sscopazzi/Portable_Weather_Station/solidworks_v2/Seperator.SLDPRT

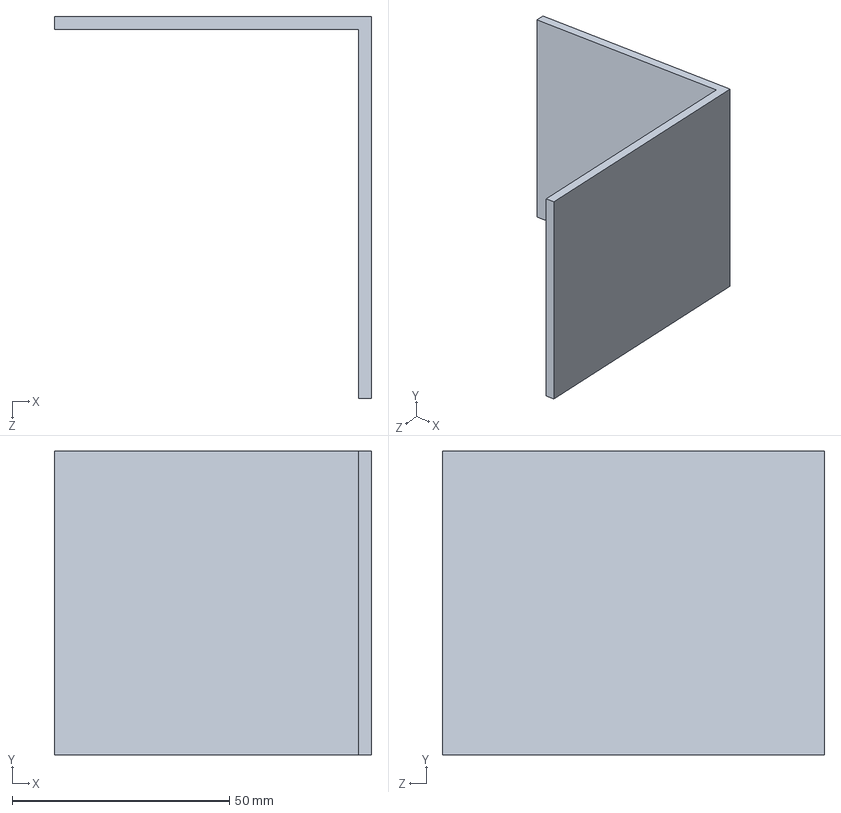
[picture p1: CAD file, 2026-06-11]
solidworks_v2/Seperator.SLDPRT
73.0 x 70.0 x 88.0 mm
