sscopazzi/Portable_Weather_Station/solidworks_v2/Hole_Cover.SLDPRT

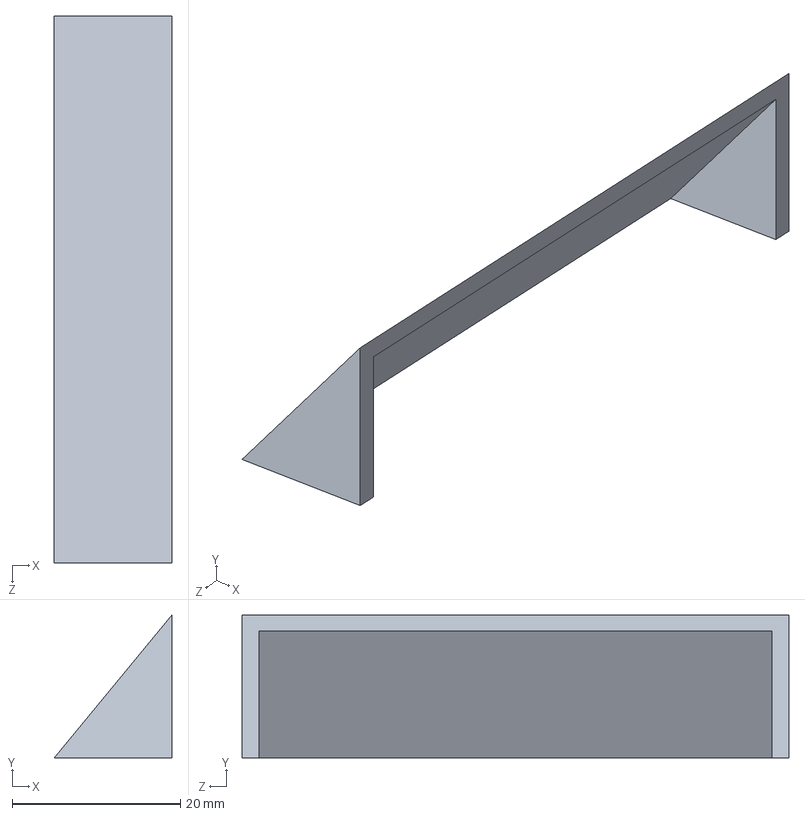
[picture p2: CAD file, 2026-06-11]
solidworks_v2/Hole_Cover.SLDPRT
14.0 x 17.0 x 65.0 mm
