sscopazzi/Portable_Weather_Station/solidworks_v2/Pin.SLDPRT

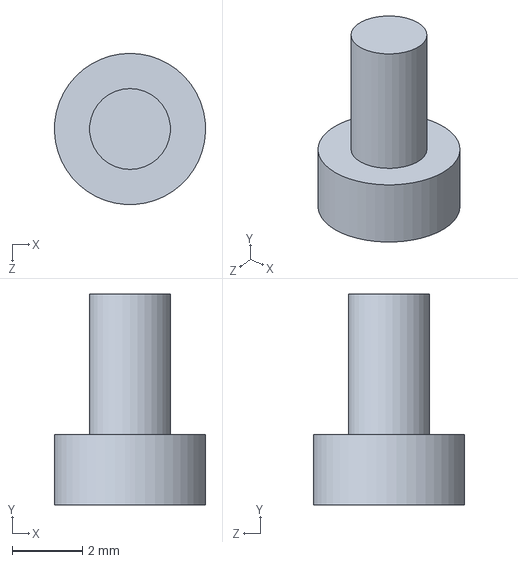
[picture p3: CAD file, 2026-06-11]
solidworks_v2/Pin.SLDPRT
4.30 x 6.00 x 4.30 mm
