sscopazzi/Portable_Weather_Station/solidworks_v2/Sensor_Tray.SLDPRT

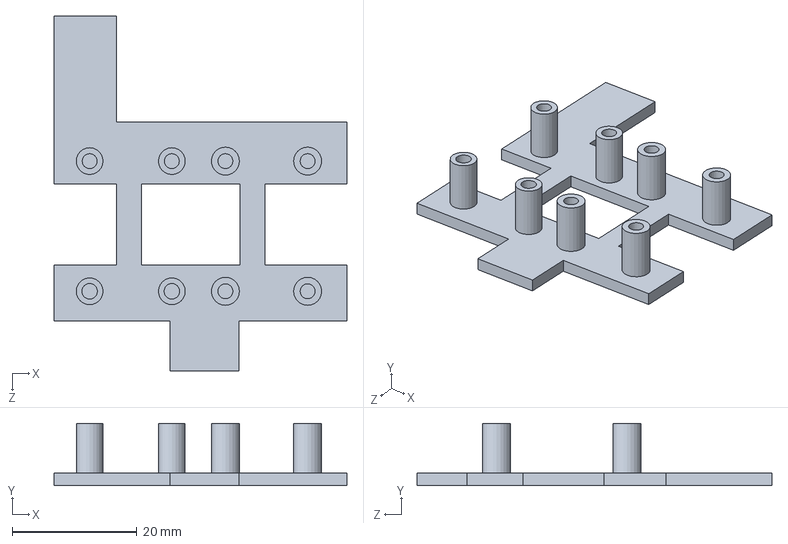
[picture p4: CAD file, 2026-06-11]
solidworks_v2/Sensor_Tray.SLDPRT
47.0 x 10.0 x 57.0 mm
