sscopazzi/Portable_Weather_Station/solidworks_v1/USBC_plug.SLDPRT

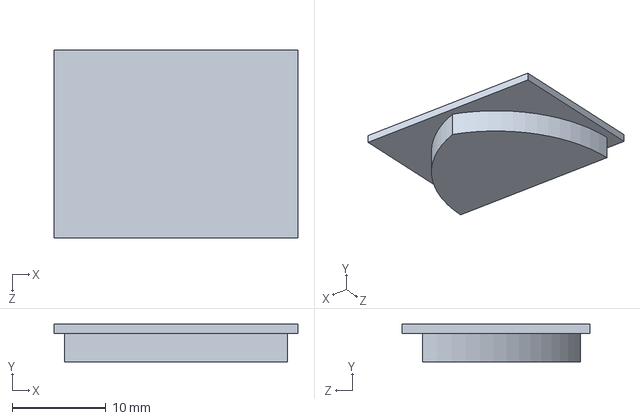
[picture p5: CAD file, 2025-03-13, an earlier design]
solidworks_v1/USBC_plug.SLDPRT
26.0 x 4.00 x 20.0 mm
