sscopazzi/Portable_Weather_Station/solidworks_v1/Box.SLDPRT

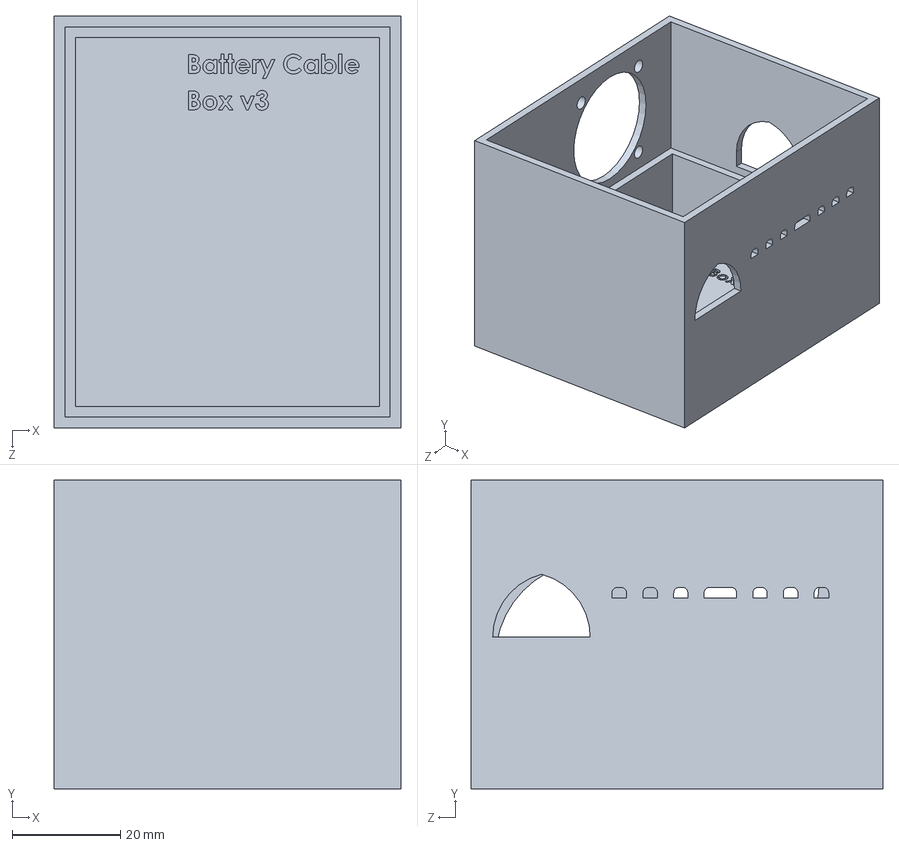
[picture p6: CAD file, 2025-03-13, an earlier design]
solidworks_v1/Box.SLDPRT
64.0 x 57.0 x 76.0 mm
