sscopazzi/Portable_Weather_Station/solidworks_v1/SD_plug.SLDPRT

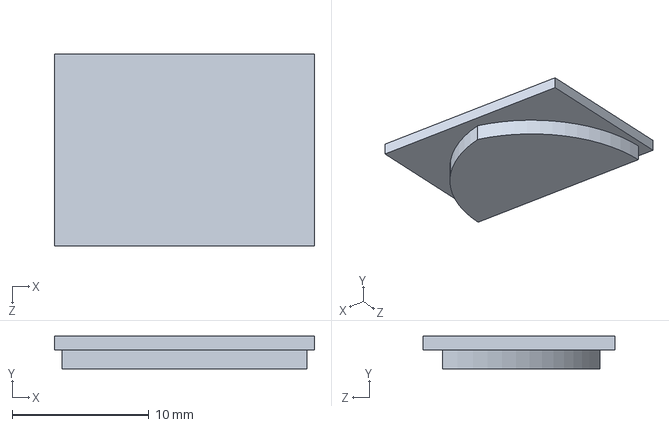
[picture p7: CAD file, 2025-03-13, an earlier design]
solidworks_v1/SD_plug.SLDPRT
19.0 x 2.40 x 14.0 mm
