sscopazzi/Portable_Weather_Station/solidworks_v1/GNSS_holders.SLDPRT

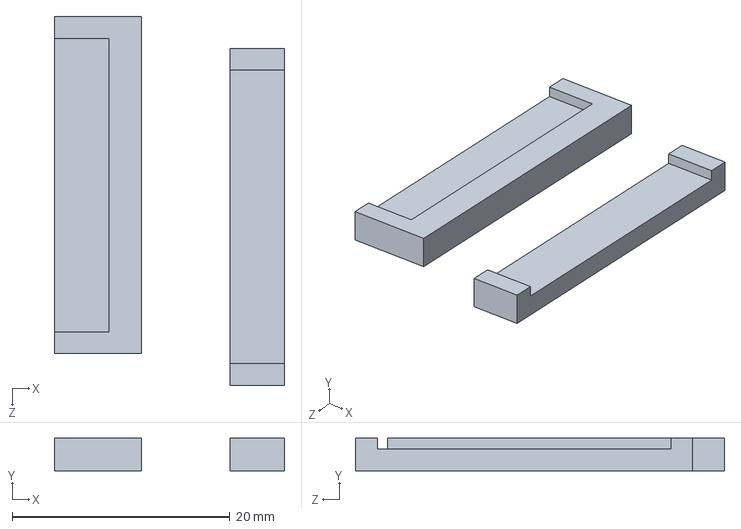
[picture p8: CAD file, 2025-03-12, an earlier design]
solidworks_v1/GNSS_holders.SLDPRT
21.2 x 3.00 x 33.9 mm
