sscopazzi/Portable_Weather_Station/solidworks_v1/Sensor_Tray.SLDPRT

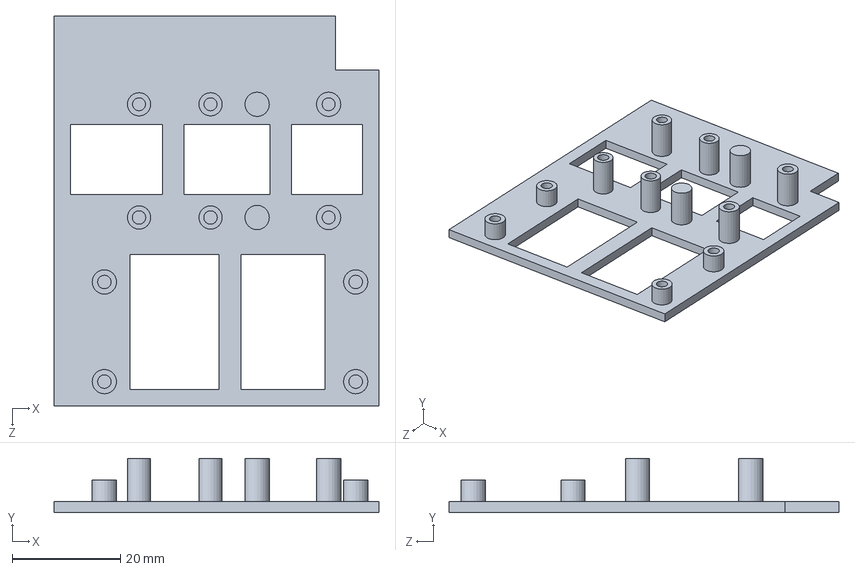
[picture p9: CAD file, 2025-03-12, an earlier design]
solidworks_v1/Sensor_Tray.SLDPRT
60.0 x 10.0 x 72.0 mm
