sscopazzi/Portable_Weather_Station/solidworks_v1/Pin.SLDPRT

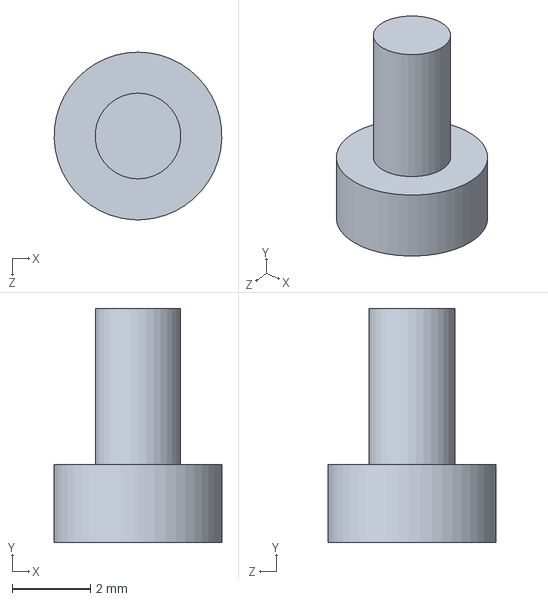
[picture p10: CAD file, 2025-03-12, an earlier design]
solidworks_v1/Pin.SLDPRT
4.30 x 6.00 x 4.30 mm
