sscopazzi/Portable_Weather_Station/solidworks_v1/Top_Cover.SLDPRT

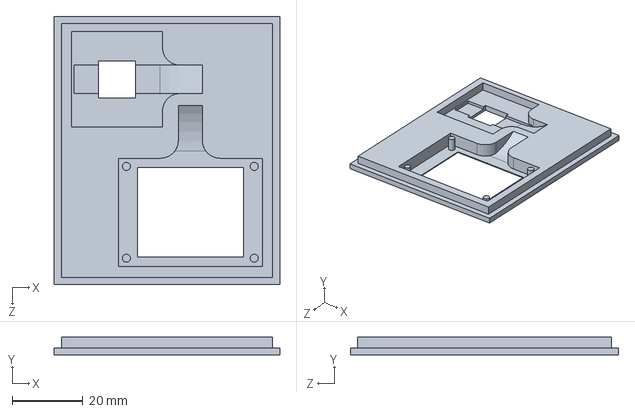
[picture p11: CAD file, 2025-03-12, an earlier design]
solidworks_v1/Top_Cover.SLDPRT
64.0 x 5.00 x 76.0 mm
