sscopazzi/Portable_Weather_Station/(list of files, cad)

Other CAD files:
solidworks_v2/Seperator_no_curve.STL
solidworks_v1/Box.STL
solidworks_v1/GNSS_holders.STL
solidworks_v1/Pin.STL
solidworks_v1/SD_plug.STL
solidworks_v1/Sensor_Tray.STL
solidworks_v1/Top_Cover.STL
solidworks_v1/USBC_plug.STL
solidworks_v2/Hole_Cover.STL
solidworks_v2/Pin.STL
solidworks_v2/Sensor_Tray.STL
solidworks_v2/Seperator.STL
