sscopazzi/Portable_Weather_Station/test_data/20240917_movingTestOne/readme.mkd

### First Walking Test

Starting at northernmost location and walking south. The position was saved every ten seconds. Walking began once a valid position was observed on display.

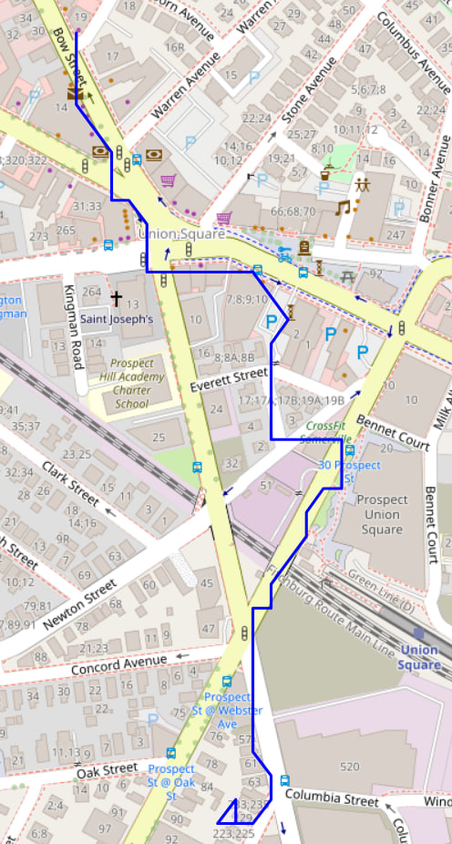
[picture p12: test_data/20240917_movingTestOne/20240917_map.png]
Map
