sscopazzi/Portable_Weather_Station/test_data/20250325_boat_test/20250325_boat_test.txt

time,tempC,tempF,humidity,pressurehPa,fix,fixQual,lat,latDir,lon,lonDir,speed,angle,alt,satNum,vBat
25-3-25 17:56:19,25.34,77.61,5.37,1014.36,1,1,38.1200,N,122.5530,W,2.70,175.87,-0.90,5,3.89
25-3-25 17:56:20,25.33,77.60,5.36,1014.37,1,1,38.1200,N,122.5530,W,2.70,179.19,-1.20,5,3.88
25-3-25 17:56:21,25.32,77.57,5.38,1014.37,1,1,38.1200,N,122.5530,W,2.70,183.11,-1.50,5,3.88
25-3-25 17:56:23,25.30,77.55,5.32,1014.37,1,1,38.1200,N,122.5530,W,2.68,190.78,-2.50,4,3.88
25-3-25 17:56:24,25.29,77.52,5.34,1014.37,1,1,38.1199,N,122.5530,W,2.74,193.00,-2.40,5,3.88
25-3-25 17:56:25,25.27,77.49,5.27,1014.37,1,1,38.1199,N,122.5530,W,2.91,194.67,-0.20,5,3.88
25-3-25 17:56:27,25.26,77.47,5.31,1014.37,1,1,38.1199,N,122.5530,W,3.45,202.16,1.50,5,3.88
25-3-25 17:56:28,25.24,77.44,5.33,1014.38,1,1,38.1199,N,122.5530,W,3.22,197.90,1.90,5,3.89
25-3-25 17:56:30,25.23,77.41,5.31,1014.39,1,1,38.1199,N,122.5530,W,2.97,203.93,2.10,5,3.88
25-3-25 17:56:31,25.21,77.39,5.33,1014.39,1,1,38.1199,N,122.5530,W,2.97,206.87,2.30,5,3.88
25-3-25 17:56:32,25.20,77.36,5.32,1014.40,1,1,38.1199,N,122.5530,W,4.77,205.92,2.30,6,3.88
25-3-25 17:56:34,25.19,77.33,5.46,1014.41,1,1,38.1198,N,122.5530,W,4.75,205.58,2.30,6,3.88
25-3-25 17:56:35,25.17,77.31,5.44,1014.44,1,1,38.1198,N,122.5531,W,2.66,217.43,2.50,6,3.88
25-3-25 17:56:36,25.16,77.30,5.36,1014.46,1,1,38.1198,N,122.5531,W,1.22,245.47,2.90,6,3.87
25-3-25 17:56:38,25.15,77.28,5.34,1014.48,1,1,38.1198,N,122.5531,W,0.45,245.47,3.00,6,3.88
25-3-25 17:56:39,25.14,77.25,5.33,1014.51,1,1,38.1198,N,122.5531,W,1.02,243.39,3.00,6,3.88
25-3-25 17:56:40,25.13,77.23,5.33,1014.53,1,1,38.1198,N,122.5531,W,1.35,246.96,2.90,6,3.90
25-3-25 17:56:42,25.12,77.22,5.62,1014.55,1,1,38.1198,N,122.5531,W,2.10,188.62,2.80,6,3.88
25-3-25 17:56:43,25.11,77.20,5.64,1014.57,1,1,38.1198,N,122.5531,W,1.66,162.24,3.30,6,3.90
25-3-25 17:56:43,25.11,77.19,5.12,1014.59,1,1,38.1198,N,122.5531,W,1.66,162.24,3.30,6,3.88
25-3-25 17:56:43,25.10,77.18,4.98,1014.60,1,1,38.1198,N,122.5531,W,1.66,162.24,3.30,6,3.87
25-3-25 17:56:43,25.09,77.17,4.98,1014.61,1,1,38.1198,N,122.5531,W,1.66,162.24,3.30,6,3.86
25-3-25 17:56:43,25.09,77.16,4.93,1014.60,1,1,38.1198,N,122.5531,W,1.66,162.24,3.30,6,3.88
25-3-25 17:56:49,25.08,77.15,5.22,1014.60,1,1,38.1197,N,122.5531,W,0.31,0.00,3.40,6,3.89
25-3-25 17:56:50,25.08,77.15,5.27,1014.60,1,1,38.1198,N,122.5531,W,0.31,0.00,3.40,6,3.90
25-3-25 17:56:52,25.08,77.15,5.22,1014.60,1,1,38.1198,N,122.5531,W,0.14,0.00,3.30,6,3.88
25-3-25 17:56:53,25.08,77.15,5.28,1014.60,1,1,38.1198,N,122.5531,W,0.12,0.00,3.30,6,3.88
25-3-25 17:56:54,25.08,77.14,5.22,1014.61,1,1,38.1198,N,122.5531,W,0.15,0.00,3.30,6,3.88
25-3-25 17:56:56,25.08,77.14,5.24,1014.61,1,1,38.1198,N,122.5531,W,0.24,0.00,3.30,6,3.88
25-3-25 17:56:57,25.08,77.14,5.20,1014.61,1,1,38.1198,N,122.5531,W,0.33,0.00,3.30,6,3.88
25-3-25 17:56:59,25.08,77.14,5.26,1014.61,1,1,38.1198,N,122.5531,W,0.24,0.00,3.30,6,3.86
25-3-25 17:57:0,25.08,77.15,5.25,1014.62,1,1,38.1198,N,122.5531,W,0.26,0.00,3.30,6,3.89
25-3-25 17:57:1,25.08,77.15,5.32,1014.63,1,1,38.1198,N,122.5531,W,0.26,0.00,3.30,6,3.88
25-3-25 17:57:3,25.08,77.15,5.31,1014.62,1,1,38.1198,N,122.5531,W,0.20,0.00,3.30,6,3.86
25-3-25 17:57:4,25.08,77.15,5.22,1014.63,1,1,38.1198,N,122.5531,W,0.27,0.00,3.30,6,3.87
25-3-25 17:57:5,25.08,77.15,5.24,1014.63,1,1,38.1198,N,122.5531,W,0.31,0.00,3.30,6,3.88
25-3-25 17:57:7,25.09,77.16,5.30,1014.63,1,1,38.1198,N,122.5531,W,0.28,0.00,3.30,6,3.89
25-3-25 17:57:8,25.10,77.17,5.26,1014.63,1,1,38.1198,N,122.5531,W,0.23,0.00,3.30,6,3.88
25-3-25 17:57:9,25.10,77.18,5.29,1014.62,1,1,38.1198,N,122.5531,W,0.23,0.00,3.30,6,3.88
25-3-25 17:57:11,25.10,77.19,5.14,1014.62,1,1,38.1198,N,122.5530,W,0.25,0.00,3.30,8,3.88
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
