sscopazzi/Portable_Weather_Station/test_data/20240917_movingTestOne/20240917_weatherstation_walkingTest.txt

time,tempC,tempF,humidity,pressurehPa,fix,fixQual,lat,latDir,lon,lonDir,speed,angle,alt,satNum
24-9-17 20:54:35,28.76,83.76,5.21,1020.81,1,1,42.2286,N,71.0583,W,0.13,352.88,22.40,4
24-9-17 20:54:47,28.74,83.73,4.88,1020.81,1,1,42.2287,N,71.0583,W,0.53,155.56,8.20,6
24-9-17 20:54:58,28.68,83.63,4.86,1020.80,1,1,42.2287,N,71.0583,W,0.43,155.56,12.80,8
24-9-17 20:55:9,28.65,83.56,5.66,1020.78,1,1,42.2286,N,71.0583,W,3.62,167.05,14.40,8
24-9-17 20:55:20,28.60,83.49,5.10,1020.75,1,1,42.2285,N,71.0583,W,3.07,164.86,12.60,8
24-9-17 20:55:31,28.59,83.46,5.14,1020.75,1,1,42.2284,N,71.0583,W,2.75,138.08,18.80,8
24-9-17 20:55:42,28.57,83.43,5.06,1020.75,1,1,42.2283,N,71.0582,W,3.66,164.23,17.50,11
24-9-17 20:55:53,28.55,83.39,5.15,1020.79,1,1,42.2283,N,71.0582,W,2.69,168.66,16.30,11
24-9-17 20:56:5,28.51,83.33,5.14,1020.81,1,1,42.2282,N,71.0581,W,3.55,172.39,14.20,11
24-9-17 20:56:16,28.51,83.33,5.21,1020.83,1,1,42.2281,N,71.0581,W,3.00,203.27,13.40,11
24-9-17 20:56:27,28.55,83.39,5.05,1020.83,1,1,42.2280,N,71.0581,W,2.85,105.85,11.90,11
24-9-17 20:56:38,28.59,83.46,5.17,1020.84,1,1,42.2280,N,71.0580,W,2.33,172.06,12.20,11
24-9-17 20:56:49,28.64,83.55,5.39,1020.87,1,1,42.2279,N,71.0579,W,0.32,119.83,10.00,12
24-9-17 20:57:0,28.66,83.58,5.26,1020.87,1,1,42.2278,N,71.0579,W,2.83,157.31,8.30,12
24-9-17 20:57:11,28.63,83.53,5.33,1020.90,1,1,42.2277,N,71.0579,W,0.09,128.30,4.80,12
24-9-17 20:57:23,28.60,83.49,5.22,1020.93,1,1,42.2277,N,71.0579,W,0.07,128.30,2.90,11
24-9-17 20:57:34,28.60,83.49,5.37,1020.95,1,1,42.2277,N,71.0579,W,2.64,91.63,4.00,12
24-9-17 20:57:45,28.64,83.55,5.42,1020.95,1,1,42.2277,N,71.0577,W,2.59,98.44,6.40,12
24-9-17 20:57:56,28.61,83.51,5.35,1020.96,1,1,42.2277,N,71.0576,W,3.34,110.71,7.50,12
24-9-17 20:58:7,28.56,83.41,5.35,1020.96,1,1,42.2277,N,71.0575,W,3.25,70.22,8.90,10
24-9-17 20:58:18,28.52,83.34,5.48,1020.98,1,1,42.2277,N,71.0574,W,3.31,107.07,10.50,12
24-9-17 20:58:30,28.46,83.23,5.42,1020.97,1,1,42.2277,N,71.0573,W,1.43,90.89,10.80,11
24-9-17 20:58:41,28.39,83.10,5.27,1020.99,1,1,42.2277,N,71.0573,W,0.58,60.97,11.70,12
24-9-17 20:58:52,28.38,83.09,5.22,1021.00,1,1,42.2277,N,71.0573,W,0.78,251.30,10.90,12
24-9-17 20:59:3,28.42,83.15,5.41,1021.01,1,1,42.2277,N,71.0573,W,0.35,233.27,10.60,12
24-9-17 20:59:14,28.47,83.24,5.76,1021.02,1,1,42.2277,N,71.0573,W,2.88,123.46,10.20,13
24-9-17 20:59:25,28.46,83.22,6.27,1021.04,1,1,42.2276,N,71.0572,W,3.29,157.08,5.10,14
24-9-17 20:59:37,28.43,83.17,5.66,1021.04,1,1,42.2275,N,71.0571,W,2.52,209.34,4.30,14
24-9-17 20:59:48,28.42,83.16,5.57,1021.03,1,1,42.2274,N,71.0572,W,2.90,182.95,1.80,14
24-9-17 20:59:59,28.41,83.15,5.83,1021.03,1,1,42.2274,N,71.0572,W,3.29,185.35,0.40,14
24-9-17 21:0:10,28.40,83.12,5.78,1021.03,1,1,42.2273,N,71.0572,W,0.24,160.46,1.60,14
24-9-17 21:0:21,28.37,83.06,5.58,1021.02,1,1,42.2272,N,71.0572,W,0.21,160.46,2.70,14
24-9-17 21:0:32,28.35,83.02,5.76,1021.01,1,1,42.2271,N,71.0572,W,2.50,171.94,5.70,13
24-9-17 21:0:44,28.30,82.95,5.70,1021.01,1,1,42.2270,N,71.0572,W,3.16,121.29,11.30,14
24-9-17 21:0:55,28.27,82.88,5.90,1020.96,1,1,42.2270,N,71.0571,W,2.32,74.65,11.40,14
24-9-17 21:1:6,28.23,82.81,5.92,1020.94,1,1,42.2270,N,71.0570,W,3.01,66.65,14.00,13
24-9-17 21:1:17,28.16,82.69,6.03,1020.96,1,1,42.2270,N,71.0569,W,1.91,108.40,13.30,14
24-9-17 21:1:28,28.09,82.57,6.93,1020.99,1,1,42.2270,N,71.0568,W,2.04,159.31,10.40,13
24-9-17 21:1:39,28.05,82.49,6.00,1021.00,1,1,42.2269,N,71.0568,W,2.16,197.99,11.90,14
24-9-17 21:1:51,27.98,82.37,5.73,1021.02,1,1,42.2269,N,71.0568,W,0.06,197.99,12.40,11
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
