sscopazzi/Portable_Weather_Station/test_data/20260610_v2_test2/2026-06-10.csv

PORTABLE WEATHER STATION v2
time | tempC | tempF | humidity | pressure_hPa | dpsTempC | vBat
2026-06-10T23:08:17 | 999.00 | 999.00 | 999.00 | 999.00 | 999.00 | 3.96
2026-06-10T23:08:17 | 999.00 | 999.00 | 999.00 | 999.00 | 999.00 | 3.96
2026-06-10T23:08:18 | 999.00 | 999.00 | 999.00 | 999.00 | 999.00 | 3.97
2026-06-10T23:08:19 | 999.00 | 999.00 | 999.00 | 999.00 | 999.00 | 3.96
2026-06-10T23:08:20 | 999.00 | 999.00 | 999.00 | 999.00 | 999.00 | 3.97
2026-06-10T23:10:23 | 999.00 | 999.00 | 999.00 | 999.00 | 999.00 | 3.99
2026-06-10T23:10:24 | 999.00 | 999.00 | 999.00 | 999.00 | 999.00 | 3.99
2026-06-10T23:10:25 | 999.00 | 999.00 | 999.00 | 999.00 | 999.00 | 3.99
2026-06-10T23:10:26 | 999.00 | 999.00 | 999.00 | 999.00 | 999.00 | 3.99
2026-06-10T23:10:27 | 999.00 | 999.00 | 999.00 | 999.00 | 999.00 | 3.99
2026-06-10T23:10:28 | 999.00 | 999.00 | 999.00 | 999.00 | 999.00 | 3.99
2026-06-10T23:10:29 | 999.00 | 999.00 | 999.00 | 999.00 | 999.00 | 4.25
2026-06-10T23:10:30 | 999.00 | 999.00 | 999.00 | 999.00 | 999.00 | 4.25
2026-06-10T23:10:31 | 999.00 | 999.00 | 999.00 | 999.00 | 999.00 | 3.99
2026-06-10T23:10:32 | 999.00 | 999.00 | 999.00 | 999.00 | 999.00 | 4.01
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
