sscopazzi/Portable_Weather_Station/test_data/20260610_v2_test2/2026-06-12.csv

PORTABLE WEATHER STATION v2
time | tempC | tempF | humidity | dewPointC | pressure_hPa | dpsTempC | rp2040TempC | vBat
2026-06-12T00:00:00 | 26.25 | 79.25 | 53.42 | 16.03 | 1002.77 | 26.42 | 37.91 | 3.68
2026-06-12T00:00:01 | 26.25 | 79.25 | 53.44 | 16.04 | 1002.77 | 26.41 | 37.91 | 3.68
2026-06-12T00:00:02 | 26.24 | 79.23 | 53.43 | 16.03 | 1002.76 | 26.42 | 38.37 | 3.68
2026-06-12T00:00:03 | 26.22 | 79.20 | 53.48 | 16.02 | 1002.76 | 26.42 | 38.84 | 3.68
2026-06-12T00:00:04 | 26.25 | 79.25 | 53.50 | 16.06 | 1002.75 | 26.41 | 37.44 | 3.68
2026-06-12T00:00:05 | 26.25 | 79.25 | 53.54 | 16.07 | 1002.75 | 26.42 | 37.44 | 3.68
2026-06-12T00:00:06 | 26.25 | 79.25 | 53.52 | 16.06 | 1002.75 | 26.41 | 37.91 | 3.68
2026-06-12T00:00:07 | 26.26 | 79.27 | 53.49 | 16.06 | 1002.75 | 26.42 | 37.91 | 3.68
2026-06-12T00:00:08 | 26.24 | 79.23 | 53.49 | 16.04 | 1002.75 | 26.42 | 38.37 | 3.68
2026-06-12T00:00:09 | 26.22 | 79.20 | 53.48 | 16.02 | 1002.76 | 26.42 | 37.91 | 3.68
2026-06-12T00:00:10 | 26.24 | 79.23 | 53.51 | 16.05 | 1002.76 | 26.42 | 37.44 | 3.68
2026-06-12T00:00:11 | 26.25 | 79.25 | 53.55 | 16.07 | 1002.77 | 26.42 | 37.91 | 3.67
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
