sscopazzi/Portable_Weather_Station/test_data/20260610_v2_test1/2026-06-10.csv

PORTABLE WEATHER STATION v2
time | tempC | tempF | humidity | pressure_hPa | dpsTempC | vBat
2026-06-10T00:00:00 | 25.32 | 77.58 | 55.84 | 1009.18 | 25.27 | 4.18
2026-06-10T00:00:01 | 25.35 | 77.63 | 55.86 | 1009.18 | 25.27 | 4.16
2026-06-10T00:00:02 | 25.34 | 77.61 | 55.87 | 1009.18 | 25.27 | 4.18
2026-06-10T00:00:03 | 25.34 | 77.61 | 55.84 | 1009.18 | 25.27 | 4.18
2026-06-10T00:00:04 | 25.34 | 77.61 | 55.85 | 1009.18 | 25.27 | 4.17
2026-06-10T00:00:05 | 25.32 | 77.58 | 55.88 | 1009.18 | 25.27 | 4.17
2026-06-10T00:00:06 | 25.34 | 77.61 | 55.86 | 1009.18 | 25.27 | 4.17
2026-06-10T00:00:07 | 25.34 | 77.61 | 55.83 | 1009.18 | 25.28 | 4.17
2026-06-10T00:00:08 | 25.34 | 77.61 | 55.89 | 1009.19 | 25.28 | 4.18
2026-06-10T00:00:09 | 25.32 | 77.58 | 55.83 | 1009.18 | 25.27 | 4.20
2026-06-10T00:00:10 | 25.34 | 77.61 | 55.84 | 1009.19 | 25.27 | 4.17
2026-06-10T00:00:11 | 25.32 | 77.58 | 55.90 | 1009.18 | 25.27 | 4.17
2026-06-10T00:00:12 | 25.32 | 77.58 | 55.89 | 1009.19 | 25.27 | 4.17
2026-06-10T00:00:13 | 25.34 | 77.61 | 55.86 | 1009.19 | 25.28 | 4.16
2026-06-10T00:00:14 | 25.32 | 77.58 | 55.90 | 1009.19 | 25.28 | 4.17
2026-06-10T00:00:15 | 25.35 | 77.63 | 55.84 | 1009.19 | 25.27 | 4.17
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
