sscopazzi/Portable_Weather_Station/test_data/20251003_flight/20251003_flight_clean.csv

time | tempC | tempF | humidity | pressurehPa | fix | fixQual | lat | latDir | lon | lonDir | speed | angle | alt | satNum | vBat
25-10-3 11:33:11 | 24.36 | 75.86 | 8.17 | 999.84 | 1 | 1 | 41.5896 | N | 87.5404 | W | 2.24 | 41.49 | 184.20 | 4 | 3.65
25-10-3 11:33:12 | 24.38 | 75.88 | 8.39 | 999.83 | 1 | 1 | 41.5896 | N | 87.5403 | W | 2.44 | 46.00 | 184.80 | 4 | 3.66
25-10-3 11:33:14 | 24.40 | 75.91 | 8.71 | 999.83 | 1 | 1 | 41.5897 | N | 87.5403 | W | 15.21 | 90.39 | 210.20 | 5 | 3.65
25-10-3 11:33:15 | 24.42 | 75.95 | 8.79 | 999.82 | 1 | 1 | 41.5897 | N | 87.5402 | W | 15.09 | 90.37 | 209.90 | 5 | 3.64
25-10-3 11:33:16 | 24.44 | 75.98 | 8.91 | 999.82 | 1 | 1 | 41.5897 | N | 87.5402 | W | 15.12 | 90.55 | 210.00 | 5 | 3.64
25-10-3 11:33:18 | 24.46 | 76.02 | 9.18 | 999.86 | 1 | 1 | 41.5897 | N | 87.5401 | W | 15.10 | 90.21 | 210.20 | 5 | 3.65
25-10-3 11:33:19 | 24.48 | 76.06 | 8.86 | 999.91 | 1 | 1 | 41.5897 | N | 87.5400 | W | 15.22 | 90.48 | 210.00 | 5 | 3.65
25-10-3 11:33:20 | 24.50 | 76.10 | 8.44 | 999.98 | 1 | 1 | 41.5897 | N | 87.5399 | W | 15.35 | 91.22 | 210.00 | 5 | 3.63
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
