sscopazzi/Portable_Weather_Station/test_data/20251003_flight/20251003_flight_raw.csv

time | tempC | tempF | humidity | pressurehPa | fix | fixQual | lat | latDir | lon | lonDir | speed | angle | alt | satNum | vBat
0-0-0 0:0:0 | 22.49 | 72.49 | 19.27 | 842.80 | 0 | 0 | 0.0000 |  | 0.0000 |  | 0.00 | 0.00 | 0.00 | 0 | 3.63
0-0-0 0:0:0 | 23.75 | 74.74 | 10.74 | 1000.64 | 0 | 0 | 0.0000 |  | 0.0000 |  | 0.00 | 0.00 | 0.00 | 0 | 3.65
0-0-0 0:0:0 | 23.75 | 74.75 | 8.96 | 1000.66 | 0 | 0 | 0.0000 |  | 0.0000 |  | 0.00 | 0.00 | 0.00 | 0 | 3.64
0-0-0 0:0:0 | 23.75 | 74.75 | 8.60 | 1000.65 | 0 | 0 | 0.0000 |  | 0.0000 |  | 0.00 | 0.00 | 0.00 | 0 | 3.66
0-0-0 0:0:0 | 23.76 | 74.76 | 8.61 | 1000.64 | 0 | 0 | 0.0000 |  | 0.0000 |  | 0.00 | 0.00 | 0.00 | 0 | 3.65
0-0-0 0:0:0 | 23.76 | 74.77 | 8.37 | 1000.62 | 0 | 0 | 0.0000 |  | 0.0000 |  | 0.00 | 0.00 | 0.00 | 0 | 3.65
0-0-0 0:0:0 | 23.77 | 74.78 | 8.66 | 1000.62 | 0 | 0 | 0.0000 |  | 0.0000 |  | 0.00 | 0.00 | 0.00 | 0 | 3.66
80-1-11 11:32:37 | 23.79 | 74.81 | 9.32 | 1000.62 | 0 | 0 | 0.0000 |  | 0.0000 |  | 0.00 | 0.00 | 0.00 | 0 | 3.65
80-1-11 11:32:38 | 23.80 | 74.84 | 9.17 | 1000.61 | 0 | 0 | 0.0000 |  | 0.0000 |  | 0.00 | 0.00 | 0.00 | 0 | 3.66
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
