sscopazzi/Portable_Weather_Station/test_data/20251005_capeCod/25-10-05_20-57-14.csv

PORTABLE WEATHER STATION ver. 05 OCT 2025
Time for valid fix: 404
time | tempC | tempF | humidity | pressurehPa | fix | fixQual | lat | latDir | lon | lonDir | speed | angle | alt | satNum | vBat
25-10-5 21:0:50 | 27.61 | 81.69 | 25.83 | 1024.23 | 1 | 1 | 4134.0922852 | N | -7039.6284180 | W | 29.07 | 189.95 | -1.70 | 12 | 3.62
25-10-5 21:1:1 | 27.61 | 81.69 | 25.70 | 1024.25 | 1 | 1 | 4133.9389648 | N | -7039.6030273 | W | 30.09 | 162.86 | 2.00 | 12 | 3.63
25-10-5 21:1:12 | 27.60 | 81.68 | 25.31 | 1024.24 | 1 | 1 | 4133.8056641 | N | -7039.6079102 | W | 29.07 | 194.06 | 0.30 | 12 | 3.62
25-10-5 21:1:23 | 27.59 | 81.66 | 25.65 | 1024.25 | 1 | 1 | 4133.6650391 | N | -7039.6220703 | W | 24.94 | 166.77 | 3.70 | 12 | 3.63
25-10-5 21:1:34 | 27.58 | 81.64 | 25.66 | 1024.24 | 1 | 1 | 4133.5419922 | N | -7039.6250000 | W | 24.83 | 181.43 | 1.90 | 11 | 3.63
25-10-5 21:1:45 | 27.56 | 81.61 | 25.63 | 1024.28 | 1 | 1 | 4133.4086914 | N | -7039.5698242 | W | 28.56 | 161.09 | 5.40 | 12 | 3.63
25-10-5 21:1:57 | 27.54 | 81.58 | 25.22 | 1024.15 | 1 | 1 | 4133.2734375 | N | -7039.5380859 | W | 24.38 | 190.73 | 6.00 | 11 | 3.64
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
