sscopazzi/Portable_Weather_Station/test_data/20251005_capeCod/25-10-06_12-08-21_raw.csv

PORTABLE WEATHER STATION ver. 05 OCT 2025
Time for valid fix: 630
time | tempC | tempF | humidity | pressurehPa | fix | fixQual | lat | latDir | lon | lonDir | speed | angle | alt | satNum | vBat
25-10-6 12:8:21 | 22.49 | 72.49 | 33.97 | 842.80 | 0 | 0 | 0.0000000 |  | 0.0000000 |  | 0.00 | 0.00 | 0.00 | 0 | 3.58
25-10-6 12:11:13 | 24.60 | 76.29 | 23.12 | 1024.57 | 1 | 1 | 41.5440178 | N | -70.6496735 | W | 4.06 | 198.49 | 58.90 | 9 | 3.55
25-10-6 12:11:15 | 24.60 | 76.29 | 20.52 | 1024.57 | 1 | 1 | 41.5439873 | N | -70.6496735 | W | 4.04 | 180.11 | 59.10 | 8 | 3.57
25-10-6 12:11:17 | 24.61 | 76.29 | 20.41 | 1024.59 | 1 | 1 | 41.5439606 | N | -70.6496429 | W | 5.86 | 126.22 | 59.50 | 8 | 3.57
25-10-6 12:11:19 | 24.62 | 76.31 | 21.87 | 1024.59 | 1 | 1 | 41.5439453 | N | -70.6495514 | W | 7.96 | 107.35 | 59.30 | 9 | 3.57
25-10-6 12:11:22 | 24.62 | 76.32 | 22.02 | 1024.57 | 1 | 1 | 41.5439224 | N | -70.6492920 | W | 13.94 | 104.81 | 57.50 | 9 | 3.57
25-10-6 12:11:24 | 24.63 | 76.33 | 21.89 | 1024.55 | 1 | 1 | 41.5438881 | N | -70.6491241 | W | 13.47 | 100.61 | 57.90 | 9 | 3.57
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
