sscopazzi/Portable_Weather_Station/test_data/20251005_capeCod/25-10-06_12-35-01.csv

PORTABLE WEATHER STATION ver. 05 OCT 2025
Time for valid fix: 391
time | tempC | tempF | humidity | pressurehPa | fix | fixQual | lat | latDir | lon | lonDir | speed | angle | alt | satNum | vBat
25-10-6 12:38:28 | 24.46 | 76.03 | 18.63 | 1025.50 | 1 | 1 | 41.5388680 | N | -70.6492767 | W | 30.03 | 20.61 | 13.10 | 10 | 3.55
25-10-6 12:38:33 | 24.47 | 76.04 | 15.97 | 1025.51 | 1 | 1 | 41.5396156 | N | -70.6491318 | W | 32.69 | 11.39 | 11.20 | 10 | 3.59
25-10-6 12:38:35 | 24.46 | 76.04 | 15.48 | 1025.51 | 1 | 1 | 41.5399246 | N | -70.6490631 | W | 33.32 | 10.09 | 10.80 | 9 | 3.57
25-10-6 12:38:37 | 24.47 | 76.05 | 18.11 | 1025.49 | 1 | 1 | 41.5401955 | N | -70.6489944 | W | 31.70 | 11.79 | 10.40 | 9 | 3.57
25-10-6 12:38:39 | 24.48 | 76.07 | 19.98 | 1025.44 | 1 | 1 | 41.5404701 | N | -70.6489258 | W | 30.12 | 9.90 | 10.10 | 10 | 3.58
25-10-6 12:38:42 | 24.51 | 76.11 | 20.22 | 1025.37 | 1 | 1 | 41.5408707 | N | -70.6488266 | W | 29.48 | 9.94 | 9.80 | 9 | 3.57
25-10-6 12:38:44 | 24.53 | 76.15 | 19.67 | 1025.30 | 1 | 1 | 41.5411224 | N | -70.6487732 | W | 26.97 | 7.60 | 9.50 | 9 | 3.58
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
