sscopazzi/Portable_Weather_Station/test_data/20250313_endurance/20250313_endurance_test1.jpg

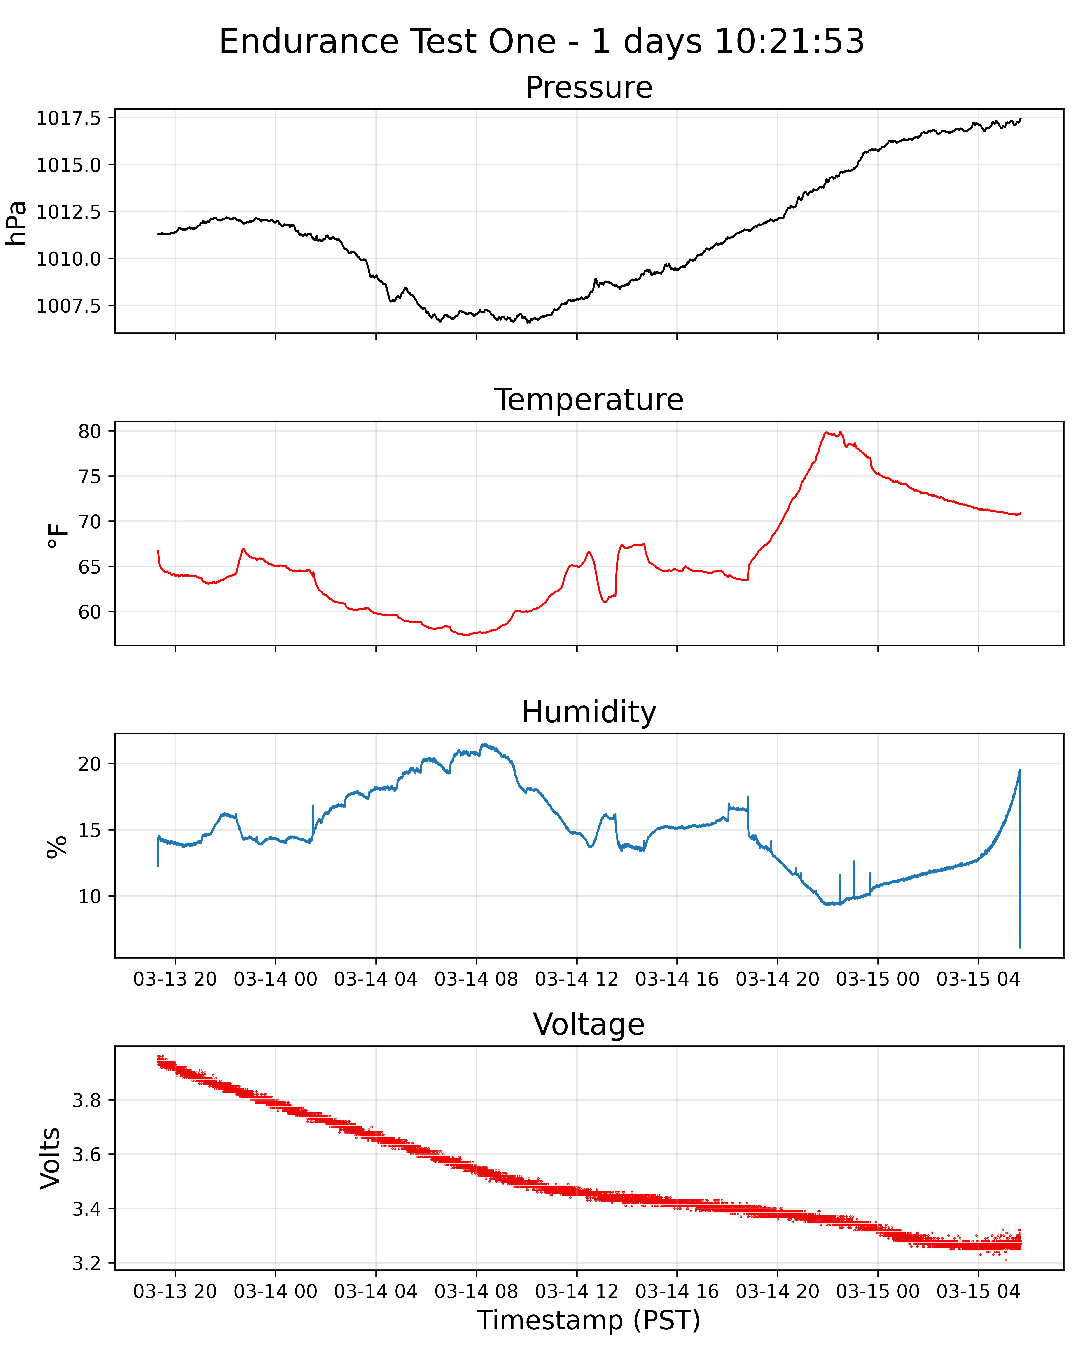
test_data/20250313_endurance/20250313_endurance_test1.jpg
