sscopazzi/Portable_Weather_Station/test_data/20250620_decimalDegreesSpeedTest/WXStation_speedTestOne_30s.jpg

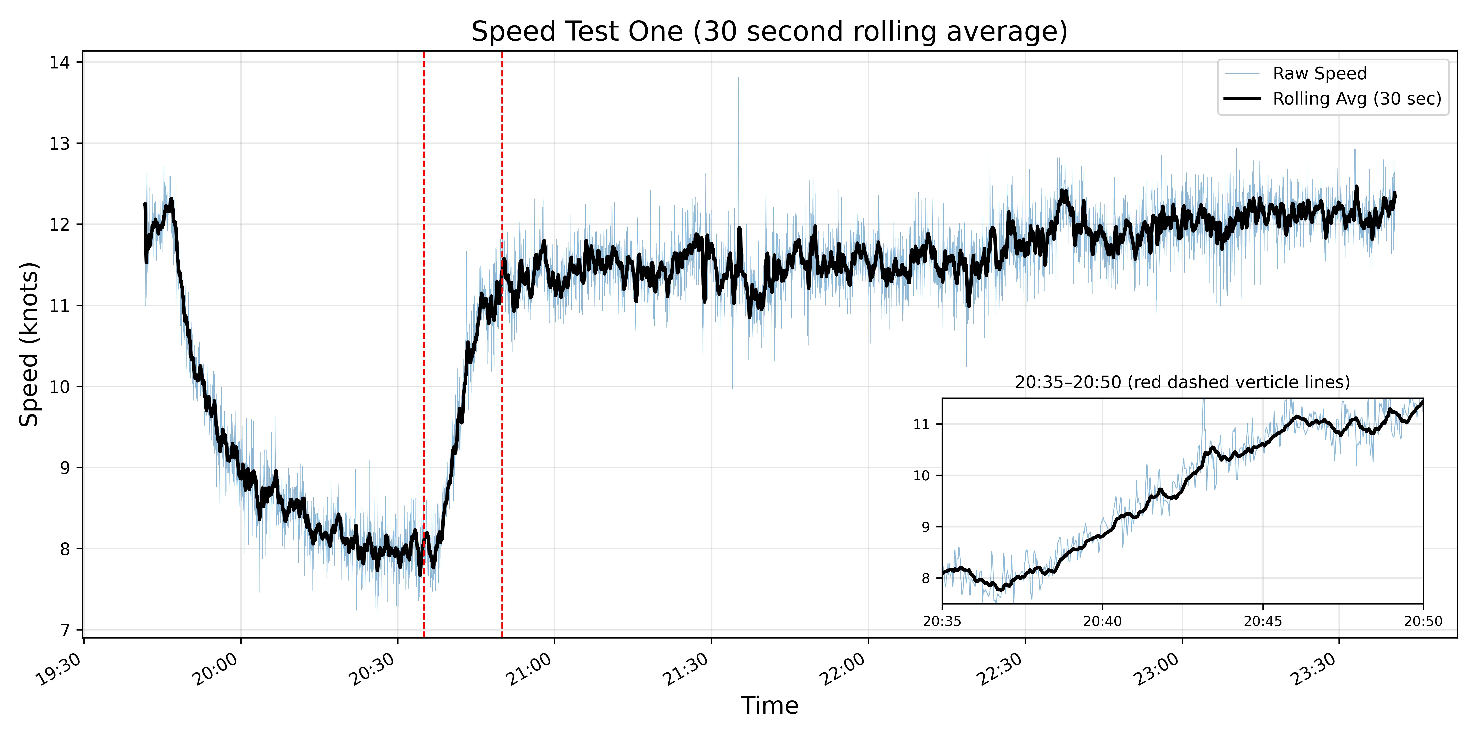
test_data/20250620_decimalDegreesSpeedTest/WXStation_speedTestOne_30s.jpg
