sscopazzi/Portable_Weather_Station/test_data/20250620_decimalDegreesSpeedTest/WXStation_speedTestOne_120s.jpg

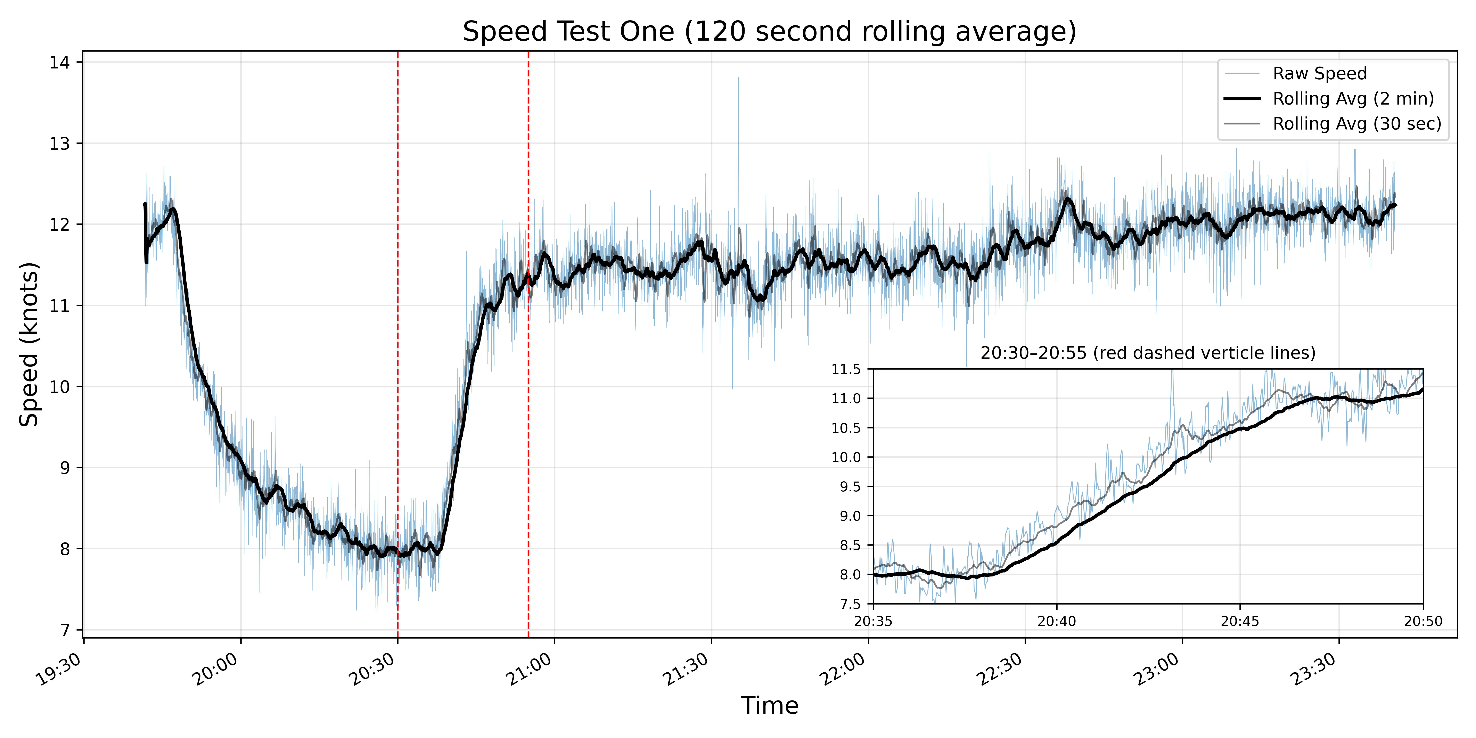
test_data/20250620_decimalDegreesSpeedTest/WXStation_speedTestOne_120s.jpg
