sscopazzi/Portable_Weather_Station/test_data/20250624_static_size/20250624_static_test.jpg

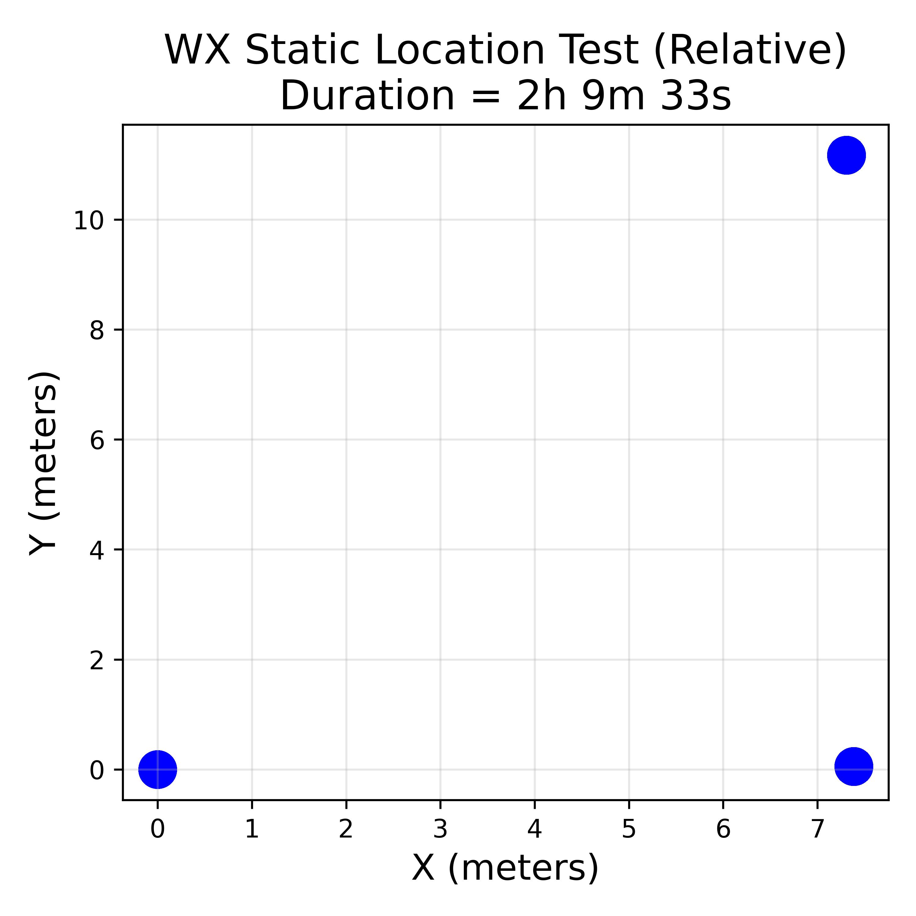
test_data/20250624_static_size/20250624_static_test.jpg
