sscopazzi/Portable_Weather_Station/test_data/20260612_v2_test3/temp_voltage_comparison.png

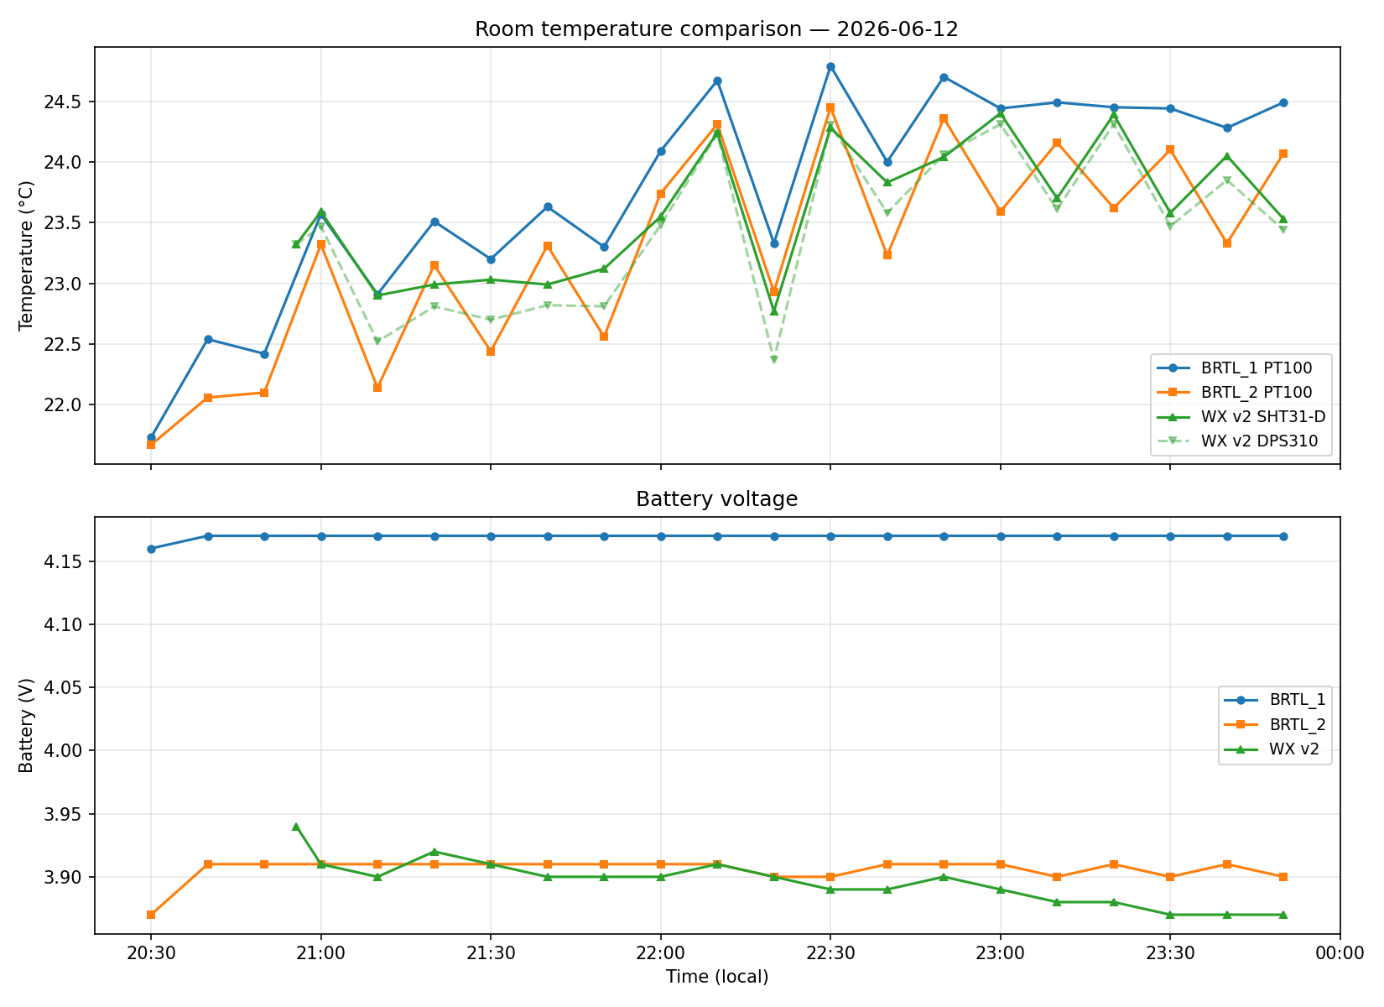
test_data/20260612_v2_test3/temp_voltage_comparison.png
