sscopazzi/Portable_Weather_Station/(commit log)

2024-09-19 fixed lat/lon parsing issue
    [display.h, weather_station_code.ino]
2025-03-12 box files, and first test of box
    [Box.SLDPRT, Box.STL, GNSS_holders.SLDPRT, GNSS_holders.STL, Pin.SLDPRT, Pin.STL, Sensor_Tray.SLDPRT, Sensor_Tray.STL]
2025-03-13 box plugs for airflow
    [Box.SLDPRT, SD_plug.SLDPRT, SD_plug.STL, USBC_plug.SLDPRT, USBC_plug.STL]
2025-03-21 location test ~2hz
2025-10-05 flight test and plots
    [20250926_flight.csv, 20251003_flight_clean.csv, 20251003_flight_raw.csv]
2025-10-14 cape cod testing
    [25-10-05_20-57-14.csv, 25-10-05_20-57-14_raw.csv, 25-10-06_12-08-21.csv, 25-10-06_12-08-21_raw.csv, 25-10-06_12-35-01.csv, 25-10-06_12-35-01_raw.csv]
2026-06-11 v2 code and STLs
    [2026-06-09.csv, 2026-06-10.csv, Box.SLDPRT, Box.STL, GNSS_holders.SLDPRT, GNSS_holders.STL, Hole_Cover.SLDPRT, Hole_Cover.STL]
2026-06-13 bench test data comparison with BRTL from SeaLabMOS
    [2026-06-10.csv, 2026-06-11.csv, 2026-06-12.csv, BRTL_1.csv, BRTL_2.csv, Hole_Cover.STL, wx_2026-06-12.csv]
2026-06-14 leaving microSD out to charge puts it into DVD voltage display mode
2026-06-27 added "wx_station_" prefix to data file
    [Datasheet_Small_Portable_WX_Station.xlsx]
